mathmuggle/heckt/sch/heckt-duino.pdf

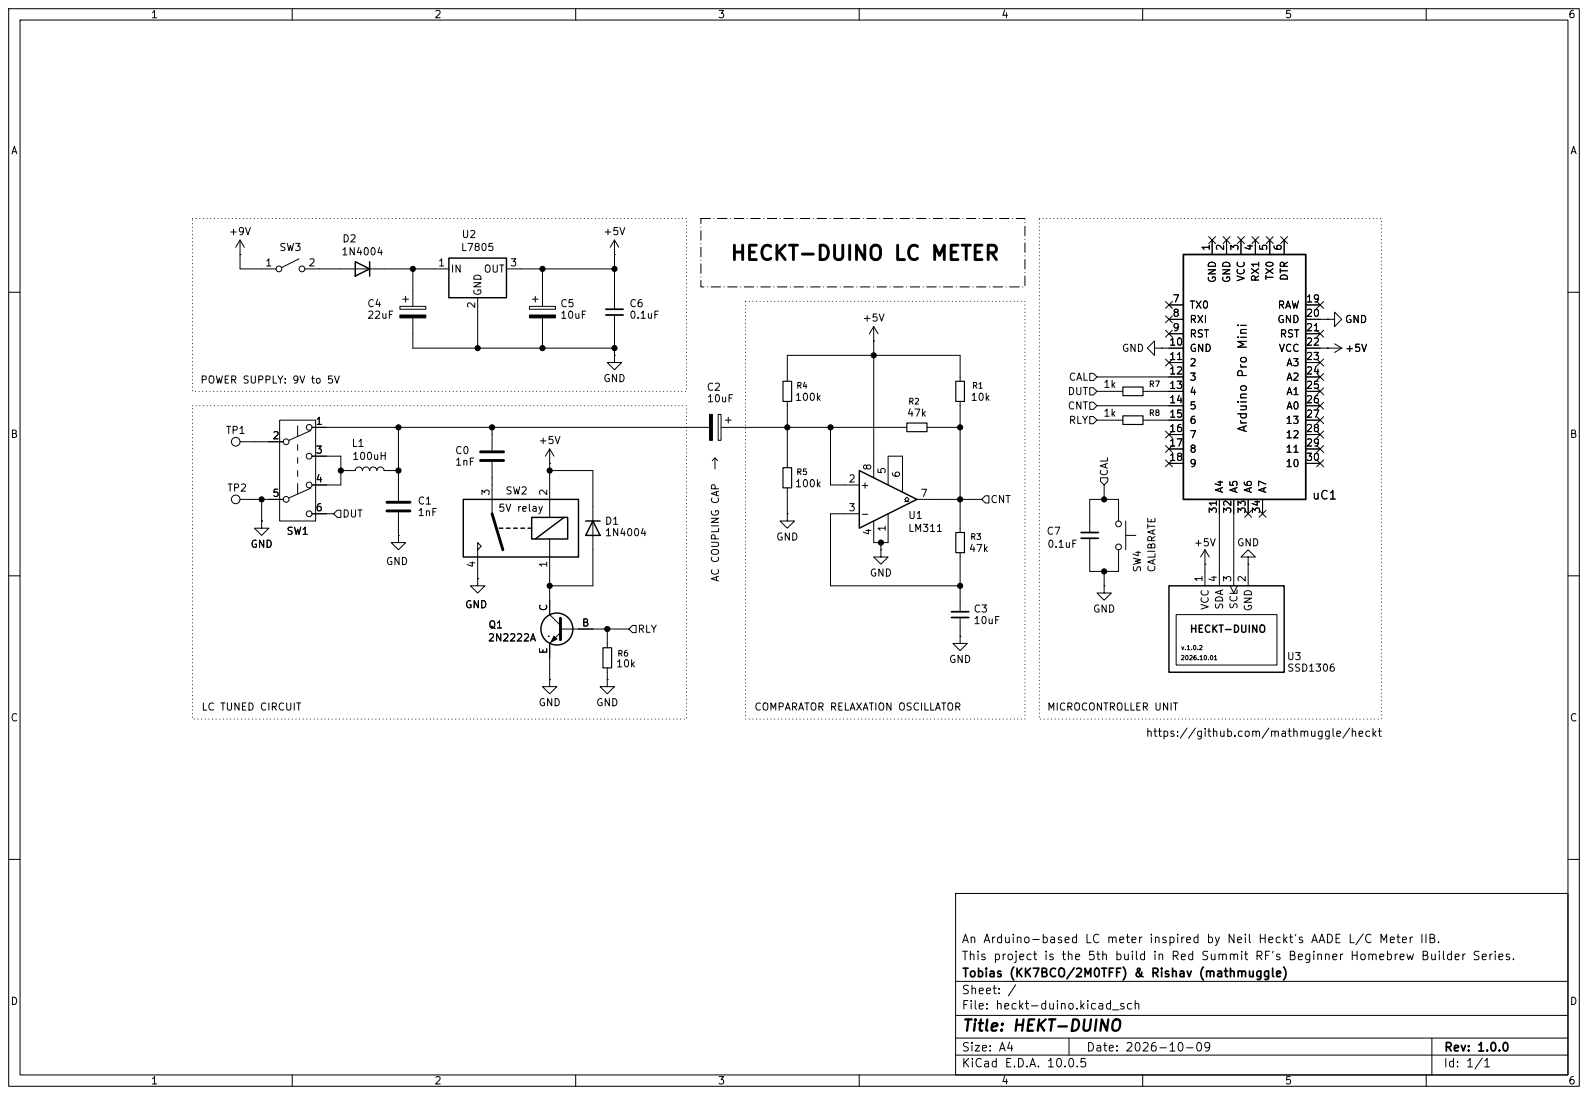
[picture p1: page 1]

HECKT-DUINO LC METER AC COUPLING CAP

An Arduino-based LC meter inspired by Neil Heckt's AADE L/C Meter IIB. 1 +

This project is the 5th build in Red Summit RF's Beginner Homebrew Builder Series.
Tobias (KK7BCO/2M0TFF) & Rishav (mathmuggle)
Sheet: /
File: heckt-duino.kicad_sch
Title: HEKT-DUINO

Size: A4 | Rev: 1.0.0
KiCad E.D.A. 10.0.5 | Id: 1/1
