mathmuggle/heckt/sch/heckt-duino.kicad_sch

## KiCad design sch/heckt-duino.kicad_sch (2026-10-09)

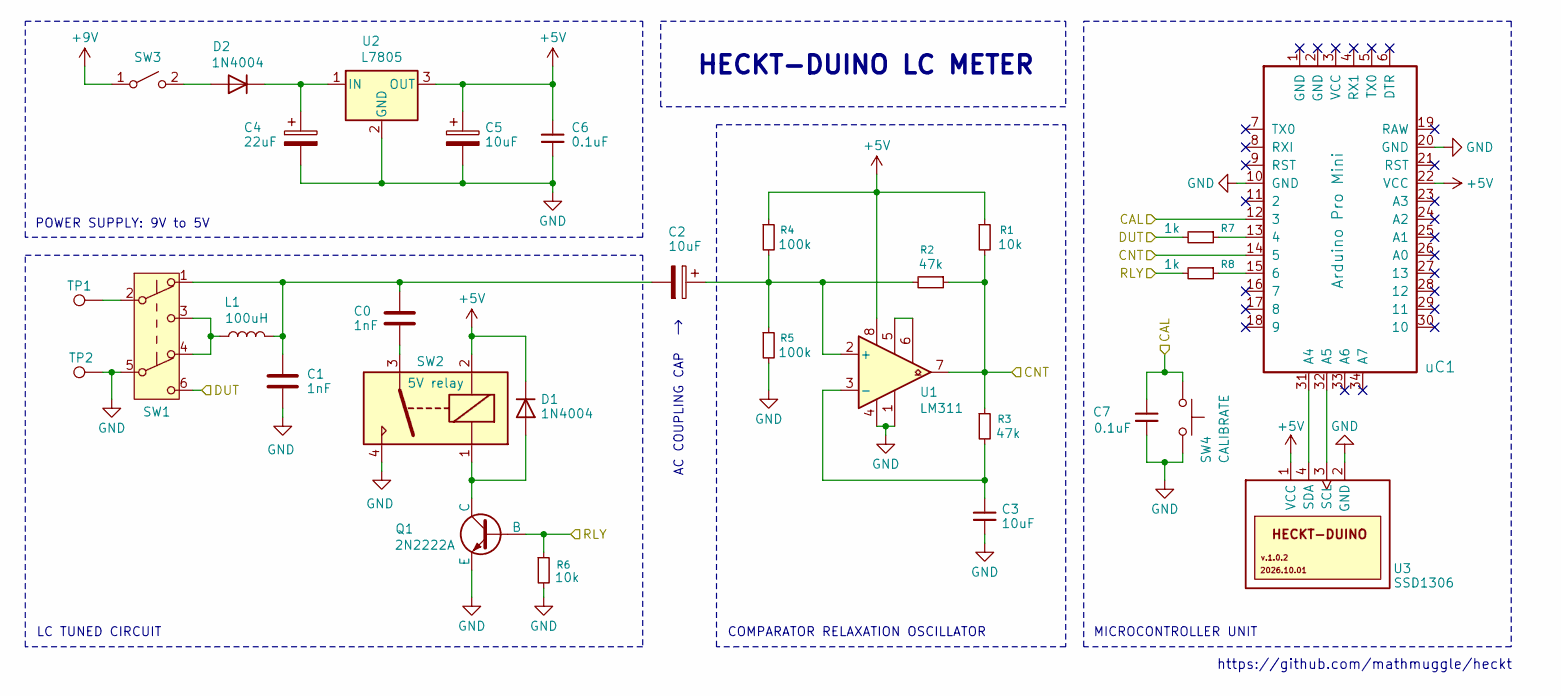
[picture p2: schematic heckt-duino.kicad_sch]

Parts:
C0, C1: 1nF
C2, C3, C5: 10uF
C4: 22uF
C6, C7: 0.1uF
D1, D2: 1N4004
L1: 100uH
Q1: 2N2222A
R1, R6: 10k
R2, R3: 47k
R4, R5: 100k
R7, R8: 1k
SW1: DPDT momentary
SW2: 5V relay
SW3: SW_SPST
SW4: CALIBRATE
TP1, TP2: TestPoint
U1: LM311
U2: L7805
U3: SSD1306
uC1: Arduino Pro Mini

Connections:
+5V: C5.1, C6.1, D1.1 (K), R1.1, R4.1, SW2.2, U1.8, U2.3 (OUT), U3.1 (VCC), uC1.22 (VCC)
+9V: SW3.1 (A)
CAL: C7.1, SW4.1, uC1.12 (3)
CNT: R1.2, R2.1, R3.1, U1.7, uC1.14 (5)
DUT: R7.2, SW1.6 (C)
GND: C1.2, C3.1, C4.2, C5.2, C6.2, C7.2, Q1.3 (E), R5.2, R6.2, SW1.5 (B), SW2.4, SW4.2, TP2.1, U1.1, U1.4, U2.2 (GND), U3.2 (GND), uC1.10 (GND), uC1.20 (GND)
unnamed: C0.1, C1.1, C2.2, L1.2, SW1.1 (A)
unnamed: C0.2, SW2.3
unnamed: C2.1, R2.2, R4.2, R5.1, U1.2 (+)
unnamed: C3.2, R3.2, U1.3 (-)
unnamed: C4.1, D2.1 (K), U2.1 (IN)
unnamed: D1.2 (A), Q1.1 (C), SW2.1
unnamed: D2.2 (A), SW3.2 (B)
unnamed: L1.1, SW1.3 (C), SW1.4 (A)
unnamed: R7.1, uC1.13 (4)
unnamed: R8.1, uC1.15 (6)
unnamed: SW1.2 (B), TP1.1
unnamed: U1.5, U1.6
unnamed: U3.3 (SCL), uC1.32 (A5)
unnamed: U3.4 (SDA), uC1.31 (A4)
RLY: Q1.2 (B), R6.1, R8.2

Notes on the sheet:
LC TUNED CIRCUIT
https://github.com/mathmuggle/heckt
COMPARATOR RELAXATION OSCILLATOR
AC COUPLING CAP
MICROCONTROLLER UNIT
POWER SUPPLY: 9V to 5V
HECKT-DUINO LC METER
