mathmuggle/heckt/(commit log)

2026-09-30 add first standalone test of the lc meter
    Important todos includes:
    1. Store the calibration parameters to EEPROM.
    2. Experiment with the larger fonts for values of L and C.
2026-09-30 increase font size for the inductance and capacitance measurements
    The size falls back to small for large numbers.
2026-09-30 store calibration params in eeprom
    Long press during startup forgets the calibration params in EEPROM.
2026-09-30 change the pin number of the push button
    Tobias and I decided to use the pins 3, 4, 5, and 6 as they are serial in the Arduino Pro Mini. Unfortunately, I had soldered my switch to pin 2 by mistake---hence the change to avoid confusions.
    [config.h]
2026-10-01 replace version.h with config.h
    Last night, I renamed version.h to the more appropriate config.h, pushed the commit as v1.0.0, and shared the updates with Tobias for him to test on his end. Only this morning his text made me realize that I hadn't tested the code after the rename---and references to version.h were still lurking throughout the codebase.
    [config.h, fw.ino, gui.cpp, lc.cpp]
2026-10-09 add the first version of the complete circuit
2026-10-14 add frequency display feature for debugging This is a feature, the idea of which came to us during the end of our podcast. Charlie asked us if any special test equipment was required during the build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
    So enabling an independent frequency measurement will help us verify:
    i. isolated comparator relaxation oscillator,
    ii. operation of the LC tuned circuit with relay OFF, and
    iii. operation of the LC tuned circuit with rela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
2026-11-08 fix the value of calibration capacitor to 1 nF
    Instead of our specification of 1nF, I had used the 1.5nF polystyrene capacitors because I had a load of them laying around. The software reflected my choice of the capacitor which I noticed only when Tobias shared me some strange observations on his build.
